ScramblerUSA/Voron2-350-mods/SmartFilamentSensor/images/x-all_in.jpg

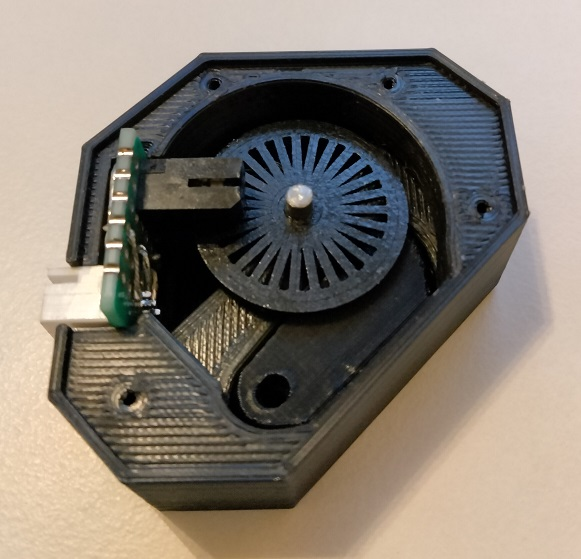
SmartFilamentSensor/images/x-all_in.jpg
