ScramblerUSA/Voron2-350-mods/SmartFilamentSensor/images/x-board_in.jpg

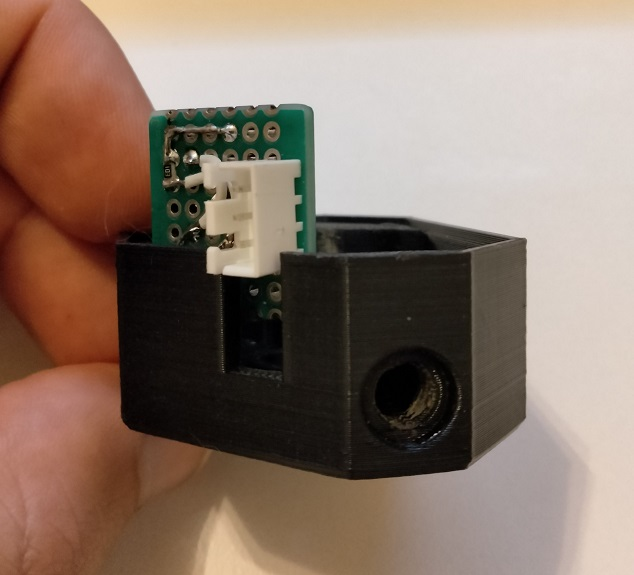
SmartFilamentSensor/images/x-board_in.jpg
