ScramblerUSA/Voron2-350-mods/CW2_Filament_Sensor/STL/main_body.stl

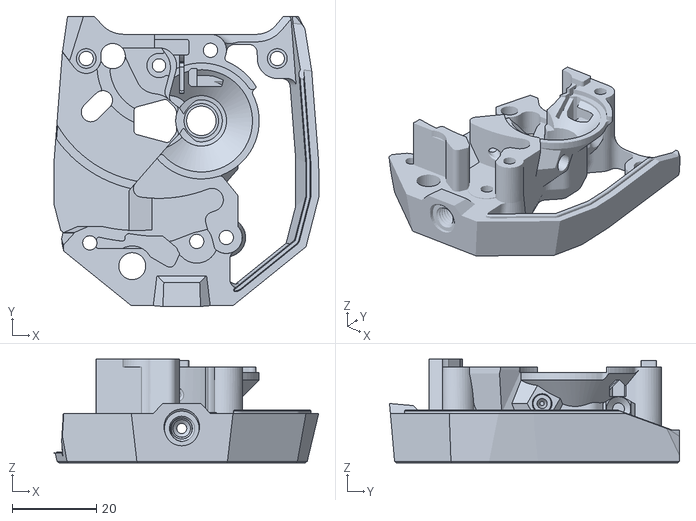
[picture p20: CAD file, 2022-11-19]
CW2_Filament_Sensor/STL/main_body.stl
62.8 x 68.9 x 24.7
