ScramblerUSA/Voron2-350-mods/CW2_Filament_Sensor/CAD/ERCF_Clockwork2.step

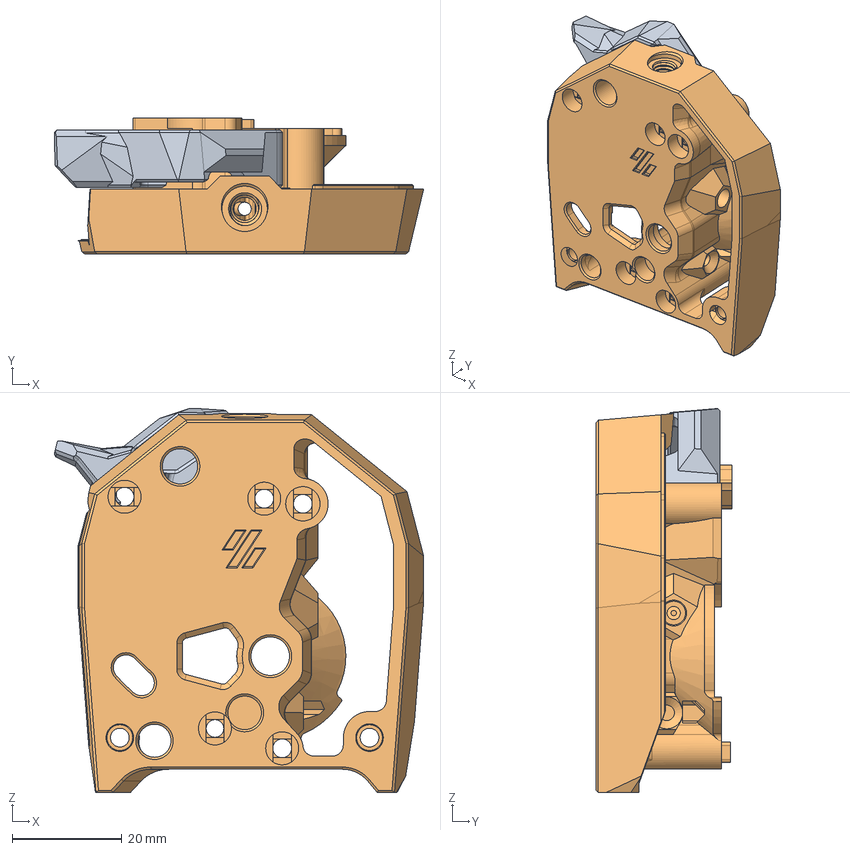
[picture p21: CAD file, 2022-11-19]
CW2_Filament_Sensor/CAD/ERCF_Clockwork2.step
67.2 x 24.7 x 69.8 mm
Latch
main_body_ECRF
