ScramblerUSA/Voron2-350-mods/QuickReleaseClips/CAD/QuickReleaseClips.step

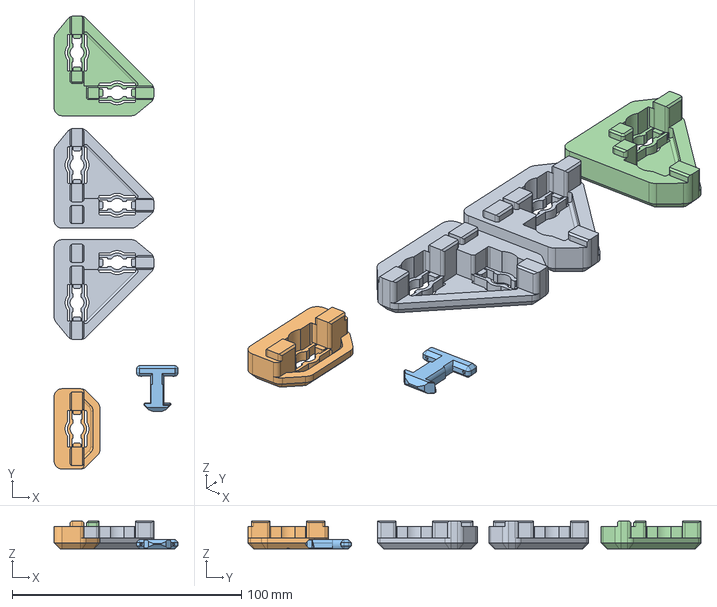
[picture p22: CAD file, 2022-11-19]
QuickReleaseClips/CAD/QuickReleaseClips.step
54.0 x 197.5 x 12.0 mm
