ScramblerUSA/Voron2-350-mods/QuickReleaseClips/STL/clip_4.5_midspan.stl

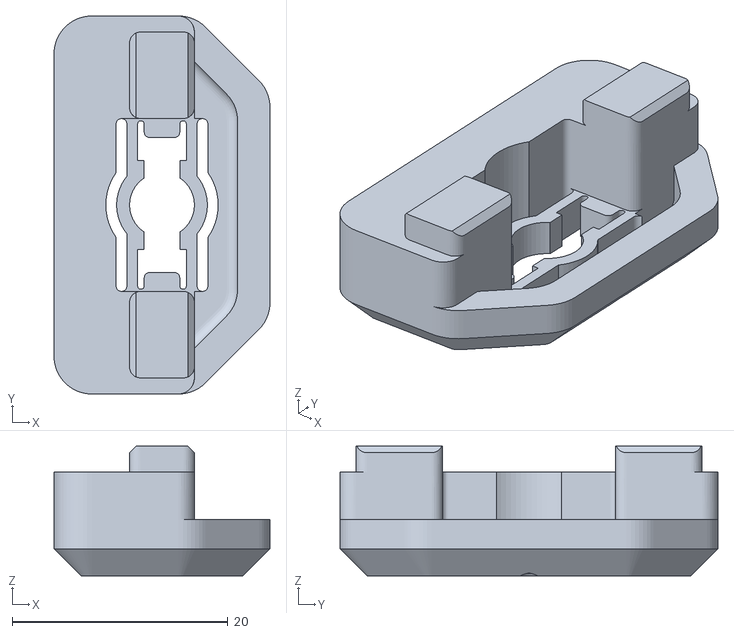
[picture p23: CAD file, 2022-11-19]
QuickReleaseClips/STL/clip_4.5_midspan.stl
20.0 x 35.0 x 12.0
