ScramblerUSA/Voron2-350-mods/SmartFilamentSensor/STL/idler.stl

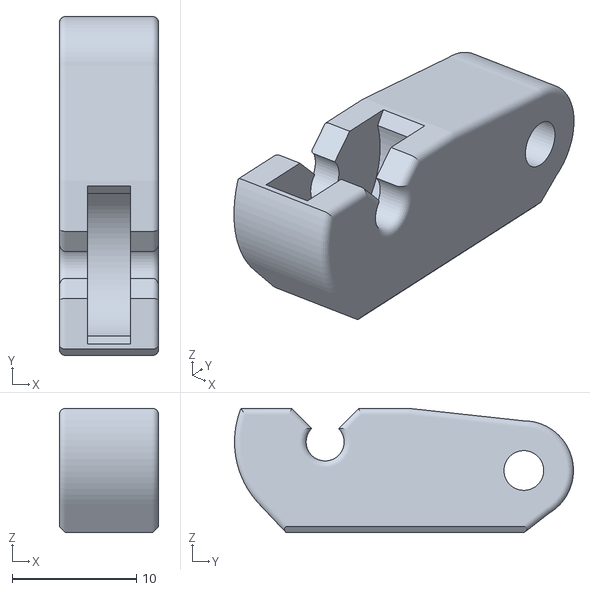
[picture p24: CAD file, 2022-11-19]
SmartFilamentSensor/STL/idler.stl
8.00 x 27.3 x 10.00
