ScramblerUSA/Voron2-350-mods/CW2_Filament_Sensor/STL/[a]_latch.stl

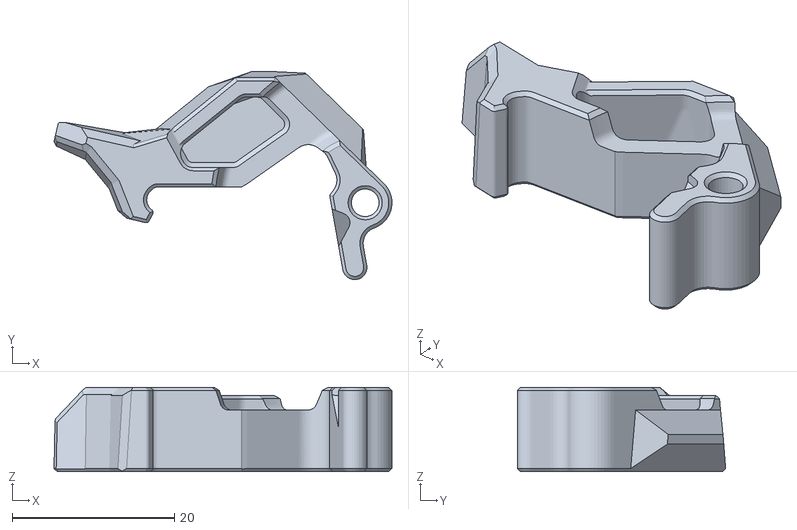
[picture p25: CAD file, 2022-11-19]
CW2_Filament_Sensor/STL/[a]_latch.stl
41.6 x 25.6 x 10.4
