ScramblerUSA/Voron2-350-mods/SmartFilamentSensor/STL/rtv_jig.stl

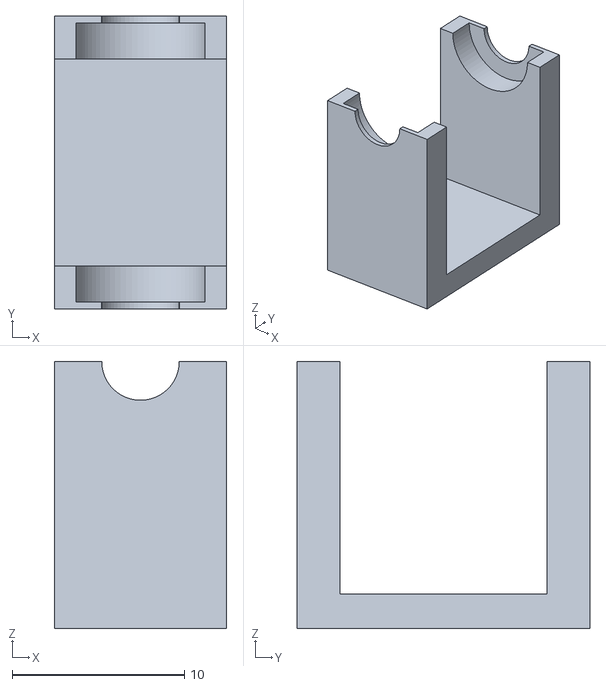
[picture p27: CAD file, 2022-11-19]
SmartFilamentSensor/STL/rtv_jig.stl
10.0 x 17.0 x 15.5
