ScramblerUSA/Voron2-350-mods/QuickReleaseClips/STL/clip_4_corner_a.stl

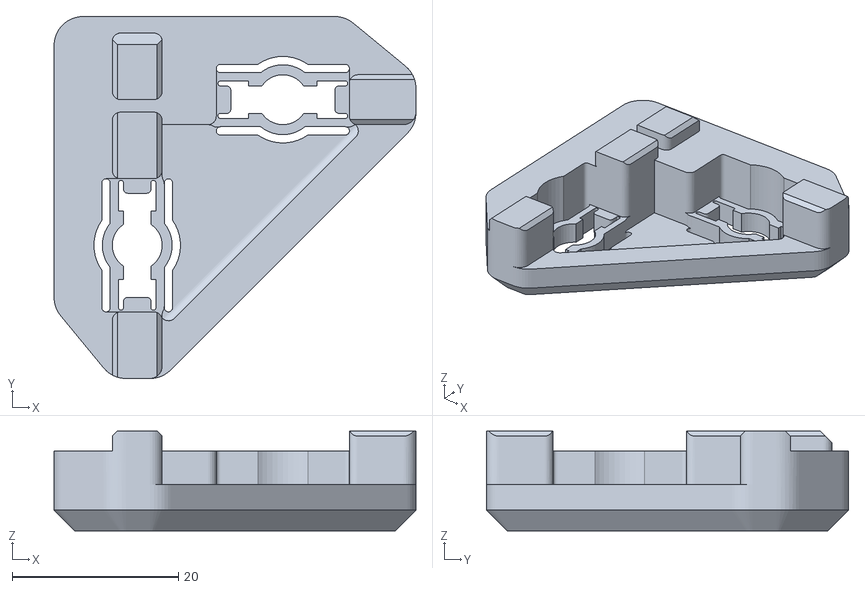
[picture p28: CAD file, 2022-11-19]
QuickReleaseClips/STL/clip_4_corner_a.stl
43.5 x 43.5 x 12.0
