ScramblerUSA/Voron2-350-mods/SmartFilamentSensor/STL/lid_m2.stl

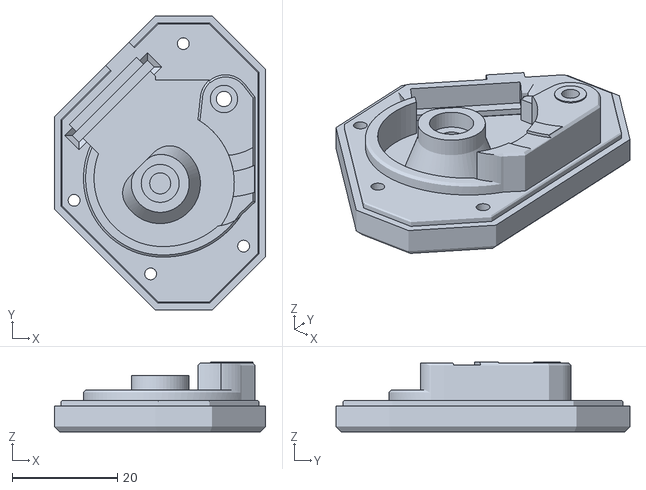
[picture p29: CAD file, 2022-11-19]
SmartFilamentSensor/STL/lid_m2.stl
40.1 x 55.8 x 13.2
