ScramblerUSA/Voron2-350-mods/SmartFilamentSensor/STL/case_plug.stl

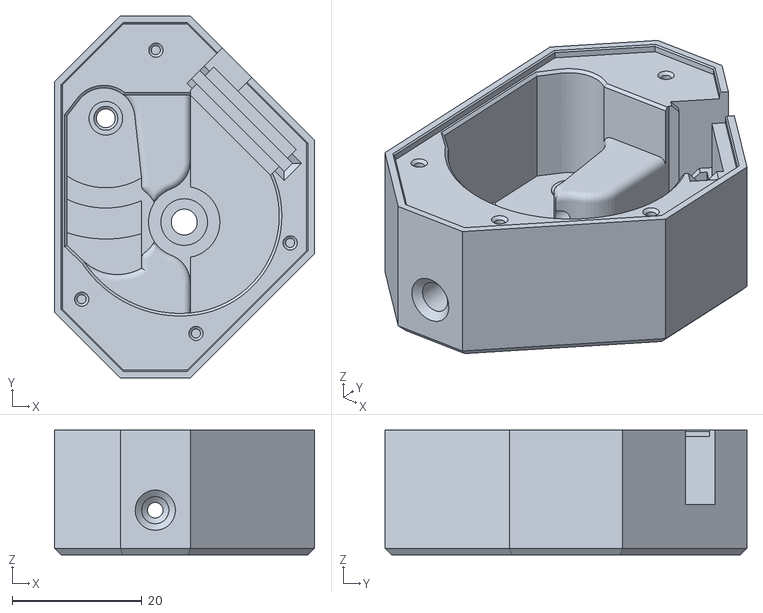
[picture p30: CAD file, 2022-11-19]
SmartFilamentSensor/STL/case_plug.stl
40.1 x 55.8 x 19.2
