ScramblerUSA/Voron2-350-mods/SmartFilamentSensor/STL/case_fit.stl

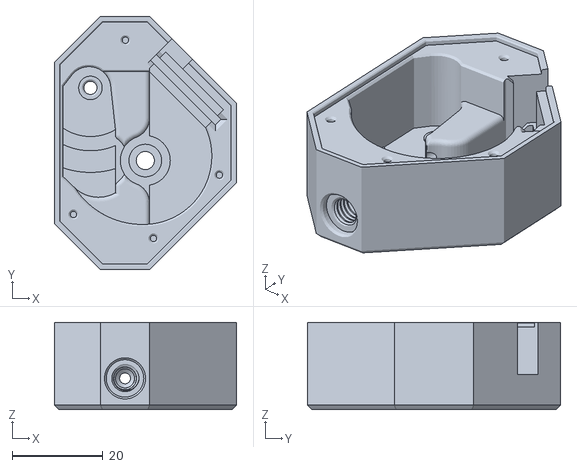
[picture p31: CAD file, 2022-11-19]
SmartFilamentSensor/STL/case_fit.stl
40.1 x 55.8 x 19.2
