ScramblerUSA/Voron2-350-mods/SmartFilamentSensor/STL/lid_sae.stl

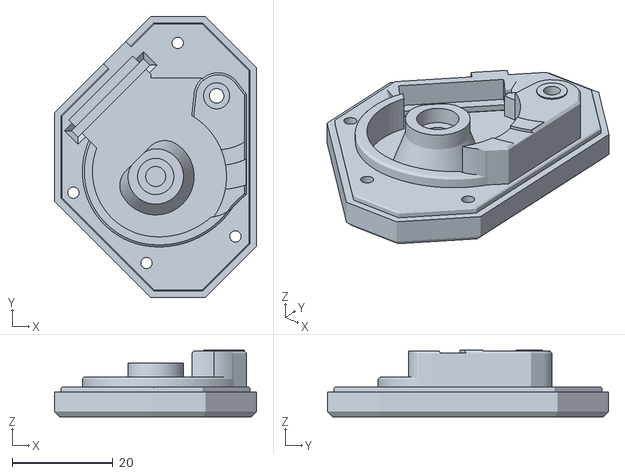
[picture p32: CAD file, 2022-11-19]
SmartFilamentSensor/STL/lid_sae.stl
40.1 x 55.8 x 13.2
