ScramblerUSA/Voron2-350-mods/SmartFilamentSensor/STL/wheel.stl

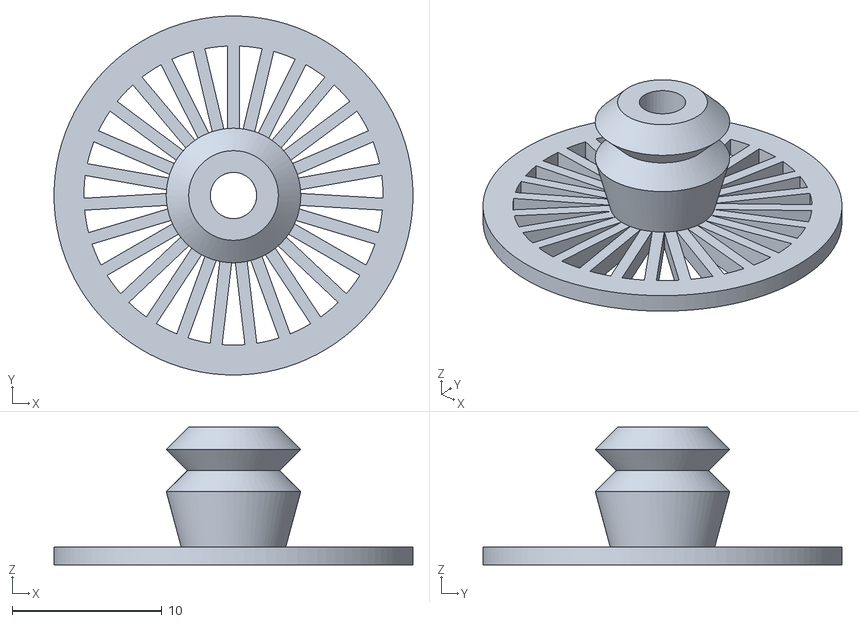
[picture p33: CAD file, 2022-11-19]
SmartFilamentSensor/STL/wheel.stl
24.0 x 24.0 x 9.20
