ScramblerUSA/Voron2-350-mods/QuickReleaseClips/STL/[a]_key.stl

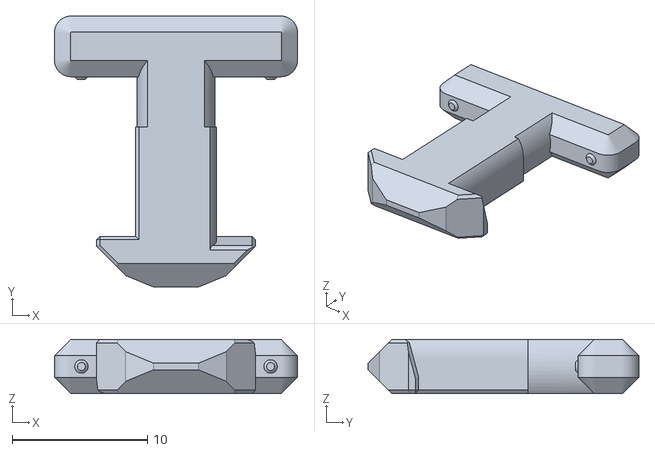
[picture p34: CAD file, 2022-11-19]
QuickReleaseClips/STL/[a]_key.stl
18.0 x 20.1 x 4.00
