ScramblerUSA/Voron2-350-mods/QuickReleaseClips/STL/clip_3_midspan.stl

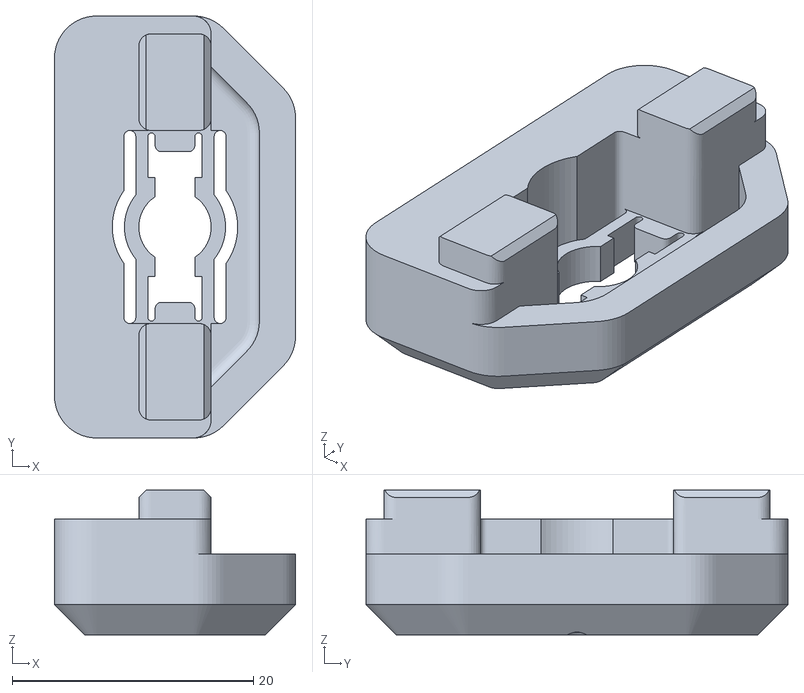
[picture p35: CAD file, 2022-11-19]
QuickReleaseClips/STL/clip_3_midspan.stl
20.0 x 35.0 x 12.0
