ScramblerUSA/Voron2-350-mods/(list of files, cad)

Other CAD files:
QuickReleaseClips/STL/clip_4_corner_top.stl
QuickReleaseClips/STL/clip_3.5_midspan.stl
QuickReleaseClips/STL/clip_4.5_corner_a.stl
QuickReleaseClips/STL/clip_5_corner_a.stl
QuickReleaseClips/STL/clip_4.5_corner_b.stl
QuickReleaseClips/STL/clip_4_midspan.stl
QuickReleaseClips/STL/clip_5_midspan.stl
QuickReleaseClips/STL/clip_5_corner_top.stl
QuickReleaseClips/STL/clip_3.5_corner_top.stl
QuickReleaseClips/STL/clip_3_corner_top.stl
QuickReleaseClips/STL/clip_5_corner_b.stl
QuickReleaseClips/STL/clip_4_corner_b.stl
QuickReleaseClips/STL/clip_3_corner_b.stl
QuickReleaseClips/STL/clip_3.5_corner_a.stl
QuickReleaseClips/STL/clip_3.5_corner_b.stl
QuickReleaseClips/STL/clip_4.5_corner_top.stl
QuickReleaseClips/CAD/LockClips.f3d
