ScramblerUSA/Voron2-350-mods/(commit log)

2022-11-19 Added QuickRelease clips and a filament sensor.
    [LockClips.f3d, QuickReleaseClips.step, [a]_key.stl, case_fit.stl, case_plug.stl, clip_3.5_corner_a.stl, clip_3.5_corner_b.stl, clip_3.5_corner_top.stl]
2022-11-19 Added CW2 filament sensor
    [ERCF_Clockwork2.step, [a]_latch.stl, main_body.stl]
